spacecraft-design-lab-2019/Solar-Panel-Z/SolarCellZ_v1.step

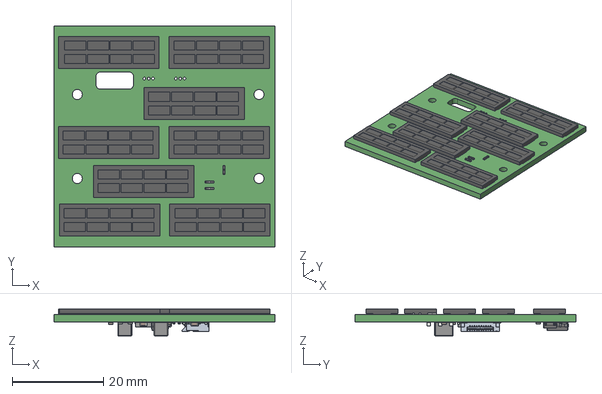
[picture p1: CAD file, 2019-12-20]
SolarCellZ_v1.step
48.4 x 48.4 x 5.90 mm
