spacecraft-design-lab-2019/Solar-Panel-Z/(commit log)

2019-10-23 Updated the mounting holes and cell arrangement
    Still working with structures on the location of the USB hole
    [SolarCellX_v1.kicad_pcb, SolarCellX_v1.sch]
2019-10-24 Added USB hole and other circuit components
    [SolarCellZ_v1.kicad_pcb, SolarCellZ_v1.sch]
2019-10-24 Added the first layer of the magnetorquer
    [SolarCellZ_v1.kicad_pcb, SolarCellZ_v1.sch]
2019-10-24 Finished Magnetorquer on Z board
    [SolarCellZ_v1.kicad_pcb]
2019-10-24 Reformatted Y+ board in new doc location.
2019-10-25 Cleaned up the Magnetorquer and added labels
    [SolarCellZ_v1.kicad_pcb]
2019-10-25 X and Z panels are ready
    [SolarCellZ_v1.kicad_pcb, SolarCellZ_v1.sch]
2019-10-26 zipped fabrication files for all but +Y
    [SolarCellZ_v1-B_Mask.gbs, SolarCellZ_v1-B_Paste.gbp, SolarCellZ_v1-B_SilkS.gbo, SolarCellZ_v1-Bottom.gbl, SolarCellZ_v1-Edge_Cuts.gm1, SolarCellZ_v1-F_Mask.gts, SolarCellZ_v1-F_Paste.gtp, SolarCellZ_v1-F_SilkS.gto]
2019-10-26 JLCPCB fab output
    [SolarCellZ_v1-B_Mask.gbr, SolarCellZ_v1-B_Paste.gbr, SolarCellZ_v1-B_SilkS.gbr, SolarCellZ_v1-Bottom.gbr, SolarCellZ_v1-Edge_Cuts.gbr, SolarCellZ_v1-F_Mask.gbr, SolarCellZ_v1-F_Paste.gbr, SolarCellZ_v1-F_SilkS.gbr]
2019-10-26 adding interactive BOMs for +/-X,-Y,+-Z
    [SolarCellX_v1.kicad_pcb, SolarCellX_v1.sch]
2019-10-26 Fixed nets again. Added proper mounting holes and pads for those mounting holes.
2019-10-28 generating 3D CAD
    [SolarCellZ_v1.kicad_pcb, SolarCellZ_v1.step]
2019-12-10 Fixed floating via, extended pads, and added flatflex labels
    [SolarCellZ_v1.kicad_pcb]
2019-12-20 v01 order + repo overhaul
    [-Z board 12-10-19.dxf, -Z board 12-11-19.dxf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]
2020-02-10 fixed schematic / pcb mismatch
    [SolarCellZ_v1.kicad_pcb, SolarCellZ_v1.sch]
2020-02-26 fixed missing 3D models, exported STEP
    [SolarCellZ_v1.kicad_pcb]
2020-02-28 Modified magnetorquer coils
    [SolarCellZ_v1.kicad_pcb]
2020-02-29 design review and generated gerbers
    [-Z board 12-10-19.dxf, -Z board 12-11-19.dxf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]
2020-03-01 added fiducials, regenerated 3d model and gerbers
    [SolarCellZ_v1-B.Mask.gbr, SolarCellZ_v1-B.Paste.gbr, SolarCellZ_v1-B.SilkS.gbr, SolarCellZ_v1-Bottom.gbr, SolarCellZ_v1-Edge.Cuts.gbr, SolarCellZ_v1-F.Mask.gbr, SolarCellZ_v1-F.Paste.gbr, SolarCellZ_v1-F.SilkS.gbr]
